ceciliaestelita/Digital-Ohmmeter/CERSE_Final_Report__Ohmmeter__ESTELITA__MENDONÇA.pdf

# Digital Ohmmeter

Grenoble INP - Ense3 / UGA CERSE – Conception et R´ealisation de Syst`emes Electroniques ´

ESTELITA COSTA Ana Cec´ılia MENDONC¸ A Eric

October 2026

## 1 Specifications Summary

The goal of this project is to design and realize a self-contained digital ohmmeter. The requirements specified for the system include:

- Measurement range: 200 Ω to 20 kΩ.
- Target precision: 1% nominal error margin.
- Automatic range switching using an integrated commutation mechanism.
- Local visual display using a standard 16 × 2 character LCD.

## 2 Objective

Measure the resistive value of an impedance and display it on an LCD screen, to be able to design a circuit following restrictions, such as a 1% error rate and find solutions using electronics components only known theoretically previously.

### 2.1 First design

The first idea for the circuit was to design a tension divisor between a potentiometer and a known resistance in series with the resistor to be measured, in which the change in the potentiometer would be the key to change the amount of current going in the other branch of resistance, for the change in current needed for higher and lower resistances, and the known resistor would be used to calculate the current, based on the known tension and resistance, so that the current could be used to calculate Rx.
This idea was not possible, due to the need of the potentiometer to be changed manually and the difficulty in finding a way to guarantee the precision.

1

### 2.2 Second Design

The second idea, was then to make a circuit maintaining the tension divisor and adding an amplifier in order to send the divided tension to the base of an also added transistor, that would make sure that the current that passes through the unknown resistor was the same one as the one that passes through a known resistor, so that it would be possible to calculate the current on the known resistance and use it to calculate the unknown.
This design did not apply well for every value of the range of resistances because the known resistance did not always have enough tension to let a reasonable amount of current pass, and that interfered when the unknown resistance was too low or too high.

### 2.3 Final Design

The circuit was then optimized with two photomos that were only activated to let current go through one resistor that let enough current through to measure the unknown resistance. The functionality is explained further below.

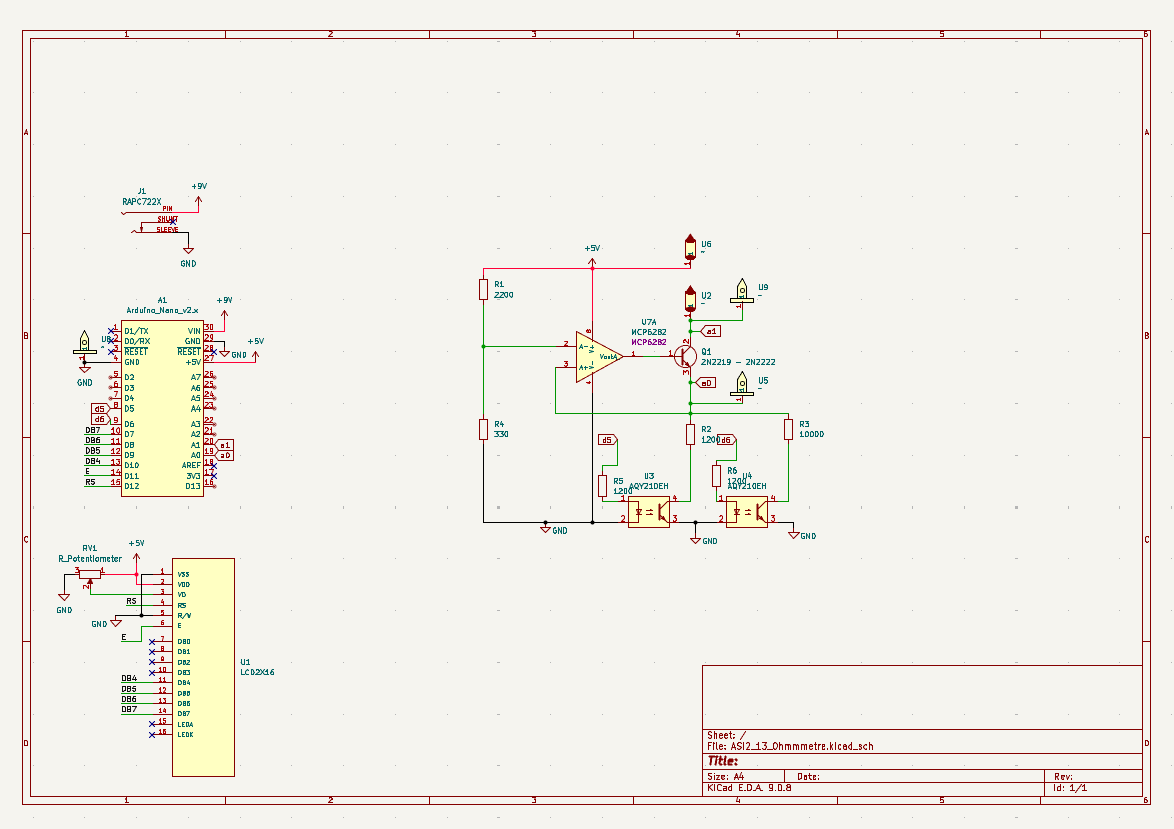
[picture p1: figure]

Figure 1: Scheme of the electrical circuit

## 3 Functionality

The NPN transistor holds the configuration of maintaing the current on the emissor the same as the sum of the colector and base:

Ie = Ic + Ib

2

As the current on the base is very low, we can assume that the current that passes through the unknown resistance has the same value as the one that passes through R2 or R3.
The circuit always starts with the reference resistance as R2, for a lower resistances range, which is used for the first calculation of the current of the circuit (I1):

I1 =

V a0
R2
That is then used in the upper part of the circuit:

Vx = 5V − V a1

Rx =

5V − V a1
I1
The choice between R2 and R3 for the real measurement is then made by a commutation system that, based of the Rx calculated, estimates if Rx is int the range of low or high resistances. If it is a low resistance, the arduino sends a digital signal from d5, if it’s high, sends a digital signal from d6.
Those digital signals are the tensions needed to activate the LED inside the photomos, that closes the circuit (as a mosfet) and lets current flow through R2 (for Rx = lower resistances) or R3 (for Rx = higher resistances).
By letting current flow, the new current is taken by the calculation of Rx, and a more precise measure is made.
This circuit is designed to work in a range of resistances between 200 Ohms and 20 kOhms with a 1% error rate.

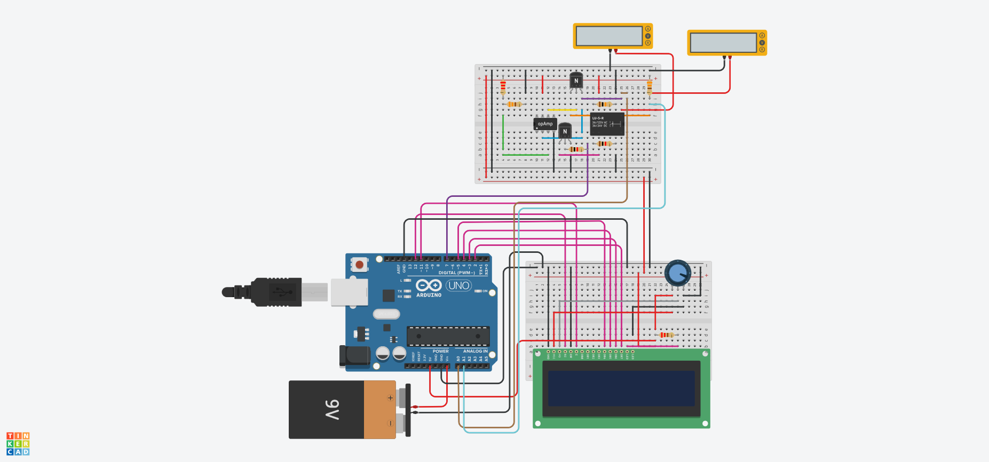
[picture p2: figure]

Figure 2: TinkerCad Circuit

TinkerCad Simulation Link: https://shorturl.at/qMHuZ

3

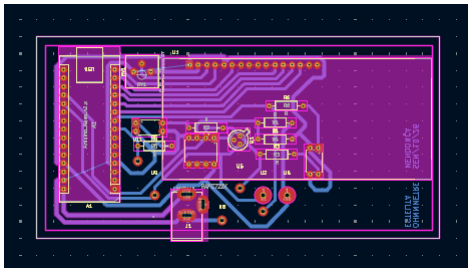
[picture p3: figure]

Figure 3: Kicad PCB scheme

## 4 Results

Due to external issues in the process of printing the PCB, it was not possible to guarantee the 1% error rate precision. During the tests on the breadboard, it was possible to see the whole functionality of the circuit with issues only for resistances with a value lower than 330 Ohms, which were measured with an error higher than expected.
When the circuit was then transfered to the PCB, due to inaccuracies with extra wires and reconnections on the amplifier, the measures were not in the the precision parameters.

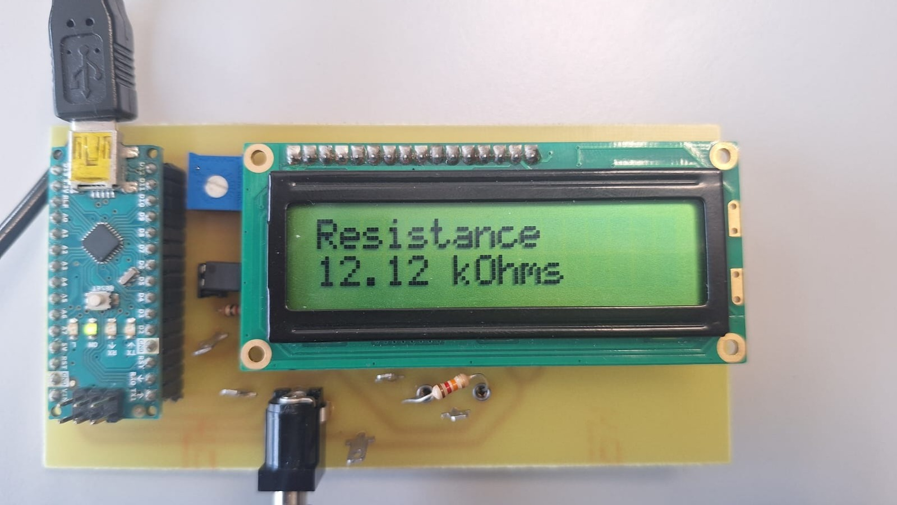
[picture p4: figure]

Figure 4: Functional Circuit on PCB

4

Table 1: Expected and displayed values

Expected Value | Displayed Value | Error
270 Ω | 261,70 Ω | 3,07%
380 Ω | 386,40 Ω | 1,68%
470 Ω | 462,10 Ω | 1,68%
560 Ω | 548,30 Ω | 2,09%
680 Ω | 668,20 Ω | 1,75%
820 Ω | 803,20 Ω | 2,05%
1,5 kΩ | 1,48 kΩ | 1,33%
2,2 kΩ | 2,15 kΩ | 2,27%
3,3 kΩ | 3,22 kΩ | 2,42%
4,7 kΩ | 4,59 kΩ | 2,34%
5,6 kΩ | 5,47 kΩ | 2,32%
6,8 kΩ | 6,82 kΩ | 0,29%
8,2 kΩ | 8,00 kΩ | 2,43%
10 kΩ | 10,08 kΩ | 0,80%
12 kΩ | 12,12 kΩ | 1,00%
15 kΩ | 14,63 kΩ | 2,47%
18 kΩ | 18,33 kΩ | 1,83%
20 kΩ | 19,51 kΩ | 2,45%

## 5 Problems and Improvements

### 5.1 Encountered Problems and Troubleshooting

- PCB printing and jumpers: Faulty trace printing necessitated manual wire jumpers across the board, which introduced parasitic resistance and voltage drops.
- Low Resistance Nonlinearity: Below 330 Ω, contact resistances and the internal ON-resistance of the photomos relay affected the tension divisor accuracy.

### 5.2 Possible Improvements

- Production of another PCB: Guaranteeing that every pin in well connected to the circuit.
- Adding another Photomos: The tension on the photomos were very close to the minimum before the saturation, the possibility of adding another photomos with a third resistance would give the project a larger margin of error to be comfortable with any measurement.

5

## 6 Flowchart of the code

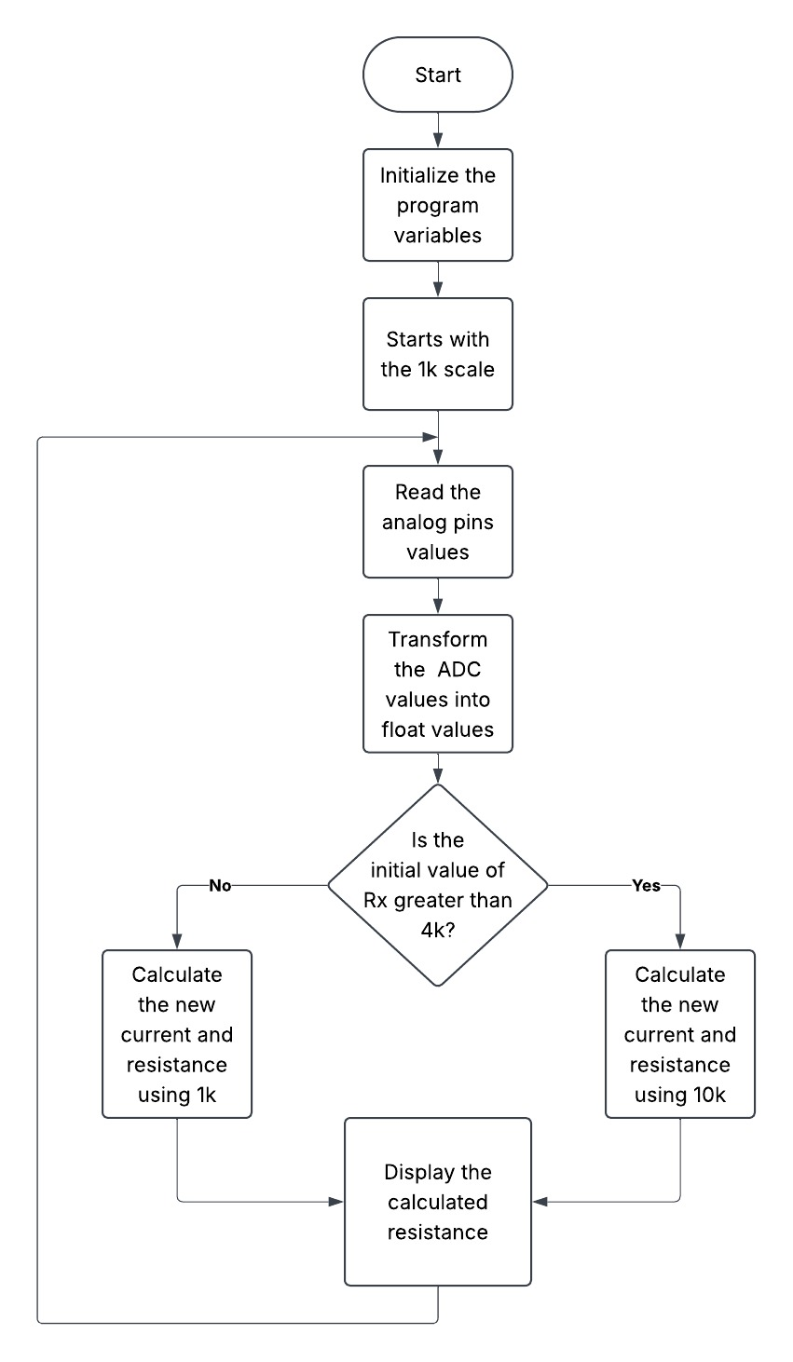
[picture p5: figure]

Figure 5: Flowchart

6

## 7 Code in C++

1 # include < LiquidCrystal .h >

2
3 | const int rs = 12 , en = 11 , d4 = 10 , d5 = 9 , d6 = 8 , d7 = 7;
4 | LiquidCrystal lcd ( rs , en , d4 , d5 , d6 , d7 ) ;

5
6 | const int pinoA0 = A0 ;
7 | const int pinoA1 = A1 ;
8 | const int pino1k = 5;
9 | const int pino10k = 6;
10 | bool escala10kAtiva = false ;
11 | bool escala1kAtiva = false ;

12
13 | void setup () {
14 | lcd . begin (16 , 2) ;
15 | pinMode ( pino1k , OUTPUT ) ;
16 | pinMode ( pino10k , OUTPUT ) ;

17
18 | // Inicia na escala de 1k
19 | digitalWrite ( pino1k , HIGH ) ;
20 | digitalWrite ( pino10k , LOW ) ;
21 | escala10kAtiva = false ;
22 | escala1kAtiva = true ;
23 | }

24
25 | void loop () {
26 | if ( escala1kAtiva ) {
27 | digitalWrite ( pino1k , HIGH ) ;
28 | digitalWrite ( pino10k , LOW ) ;
29 | escala10kAtiva = false ;
30 | } else if ( escala10kAtiva ) {
31 | digitalWrite ( pino10k , HIGH ) ;
32 | digitalWrite ( pino1k , LOW ) ;
33 | escala1kAtiva = false ;
34 | }
35 | delay (35) ;

36
37 | analogRead ( pinoA0 ) ;
38 | analogRead ( pinoA1 ) ;
39 | delay (5) ;

40
41 | long somaA0 = 0 , somaA1 = 0;
42 | for (int i = 0; i < 50; i ++) {
43 | somaA0 += analogRead ( pinoA0 ) ;
44 | somaA1 += analogRead ( pinoA1 ) ;
45 | delay (2) ;
46 | }

47

7

48 | float adcA0 = somaA0 / 50.0;
49 | float adcA1 = somaA1 / 50.0;

50
51 | float VA0 = ( adcA0 * 5.0) / 1023.0;
52 | float VA1 = ( adcA1 * 5.0) / 1023.0;

53
54 | // Seleciona a resistencia de referencia
55 | float resistenciaReferencia = escala10kAtiva ? 10000.0 :
1000.0;

56
57 float I_circuito = VA0 / resistenciaReferencia ;

58
59 | float VRx = 5.0 - VA1 ;
60 | if ( VRx < 0) VRx = 0;

61
62 | float Rx = 0;
63 | if ( I_circuito > 0.00001) {
64 | Rx = VRx / I_circuito ;
65 | }

66
67 | if ( escala10kAtiva == false && Rx >= 4000.0 ) {
68 | escala10kAtiva = true ;
69 | escala1kAtiva = false ;
70 | return ;
71 | }
72 | else if ( escala1kAtiva == false && Rx < 4000.0) {
73 | escala1kAtiva = true ;
74 | escala10kAtiva = false ;
75 | return ;
76 | }

77
78 | lcd . setCursor (0 , 0) ;
79 | lcd . print (" Resistance | ") ;
80 | lcd . setCursor (0 , 1) ;

81
82 | if ( Rx >= 1000.0) {
83 | lcd . print ( Rx / 1000.0 , 2) ;
84 | lcd . print (" kOhms | ") ;
85 | }
86 | else {
87 | lcd . print ( Rx , 1) ;
88 | lcd . print (" Ohms | ") ;
89 | }

90
91 | delay (400) ;
92 | }

8
