ceciliaestelita/Digital-Ohmmeter/Électronique et Signaux Numérique.pdf

A

1 | 2 | 3 | 4 | 5 | 6

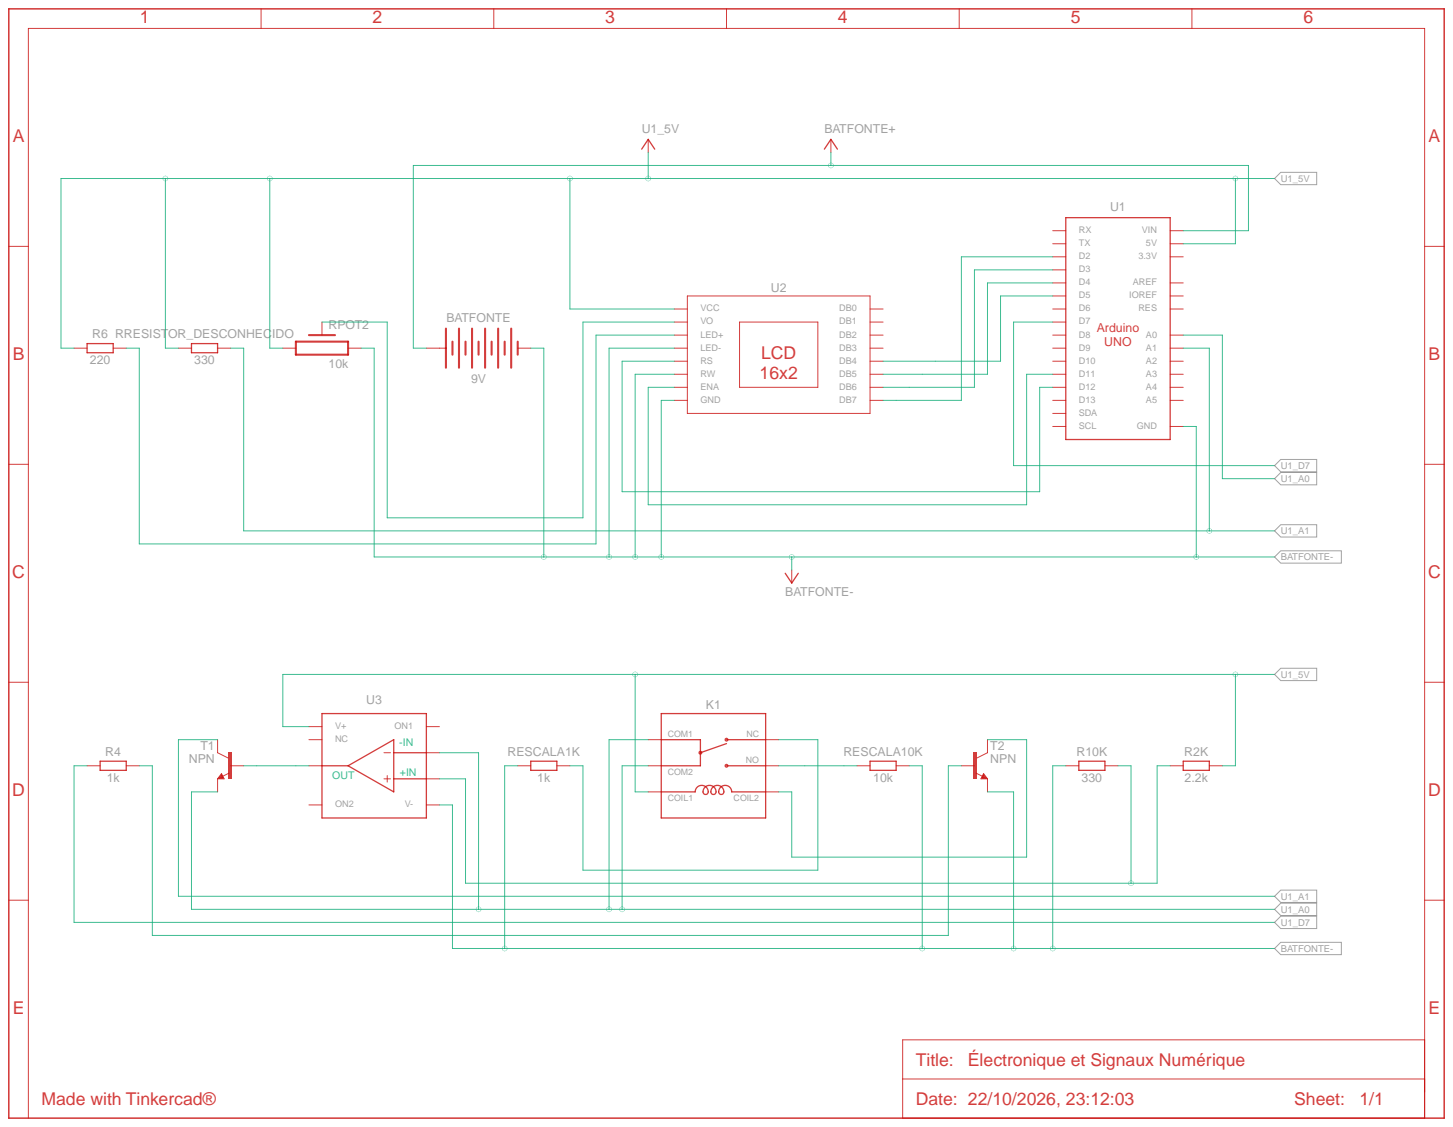
[picture p6: page 1]

Title: Électronique et Signaux Numérique
