ceciliaestelita/Digital-Ohmmeter/kicad/ASI2_13_Ohmmmetre.kicad_pcb

## KiCad design kicad/ASI2_13_Ohmmmetre.kicad_pcb (2026-10-10)

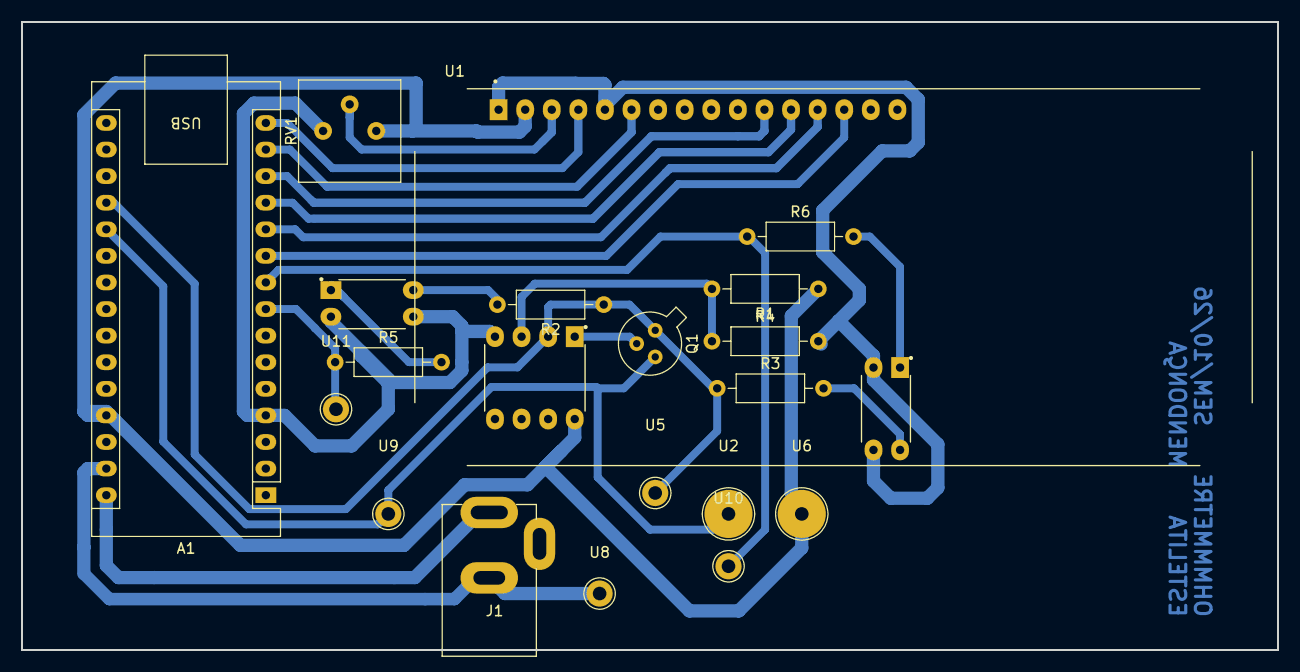
[picture p7: board ASI2_13_Ohmmmetre.kicad_pcb from above]

Board: 2 copper layers, 120.0 x 60.0 mm, 21 parts (0 on the bottom side), 20 nets.

Parts:
A1: Arduino_Nano_v2.x; Arduino_Nano
J1: RAPC722X; SWITCHCRAFT_RAPC722X
Q1: 2N2219 - 2N2222; TO-18-ENSE3
R1, R2, R3, R4, R5, R6: R; Axial_4pas
RV1: R_Potentiometer; Pot_mono
U1: LCD2X16; LCD_LCD2X16
U2, U6: canon_insertion
U3, U4: AQY210EH; DIP4
U5, U8, U9, U10, U11: point_test
U7: MCP6282; DIP8

Connections:
+5V: A1.27 (+5V), R1.1, RV1.1, U1.2 (VDD), U6.1, U7.8 (V+)
+9V: A1.30 (VIN), J1.PIN
/DB4: A1.13 (D10), U1.11 (DB4)
/DB5: A1.12 (D9), U1.12 (DB5)
/DB6: A1.11 (D8), U1.13 (DB6)
/DB7: A1.10 (D7), U1.14 (DB7)
/E: A1.14 (D11), U1.6 (E)
/RS: A1.15 (D12), U1.4 (RS)
GND: A1.4 (GND), A1.29 (GND), J1.SLEEVE, R4.2, RV1.3, U1.1 (VSS), U1.5 (R/W), U3.2, U3.3, U4.2, U4.3, U7.4 (V-), U8.1
unnamed: Q1.1 (B), U7.1 (VoutA_)
unnamed: R2.2, U3.4
unnamed: R3.2, U4.4
unnamed: R5.2, U3.1
unnamed: R6.2, U4.1
unnamed: RV1.2, U1.3 (VO)
unnamed: R1.2, R4.1, U7.3 (A+)
a0: A1.19 (A0), Q1.3 (E), R2.1, R3.1, U5.1, U7.2 (A-)
a1: A1.20 (A1), Q1.2 (C), U2.1, U9.1
d5: A1.8 (D5), R5.1, U11.1
d6: A1.9 (D6), R6.1, U10.1
