ceciliaestelita/Digital-Ohmmeter/(commit log)

2026-09-13 teste1
    Initialize LCD and read analog inputs for voltage and resistance calculations.
2026-09-16 teste2
    This code reads analog values from two pins, calculates current and resistance, and displays the results on an LCD.
2026-09-16 main corrigida para circuito com resistências ajustadas
    [main.cpp]
2026-09-16 descrição do circuito
2026-09-17 circuito atualizado com photomos
    Added images to the README for better visualization.
2026-09-17 atualização do circuito com chaveamento por optomos
    Updated image in README to a new version with different dimensions.
2026-09-23 atualizaçao circuito
    Updated image in README.md to a new source with different dimensions.
2026-10-10 arquivos do kicad
2026-10-10 pasta kicad
2026-10-10 atualização do esquema kicad
2026-10-22 att codigo
    Updated pin assignments and logic for resistance measurement. Improved handling of scale switching between 1k and 10k resistors.
2026-10-22 circuit explanation
    Updated text for clarity and added details about the circuit operation and measurement process.
2026-10-22 kicad schéma complet
    Updated the image in the README to a larger version.
